julbouln/musicboxV2/README

New "La boîte à musique" firmware https://hackaday.io/project/6391-la-bote-musique

Using libopencm3 http://libopencm3.org/wiki/Main_Page drivers and atomthreads RTOS http://atomthreads.com/
