julbouln/musicboxV2/hardware/musicbox.brd

## EAGLE design hardware/musicbox.brd (2016-02-20)

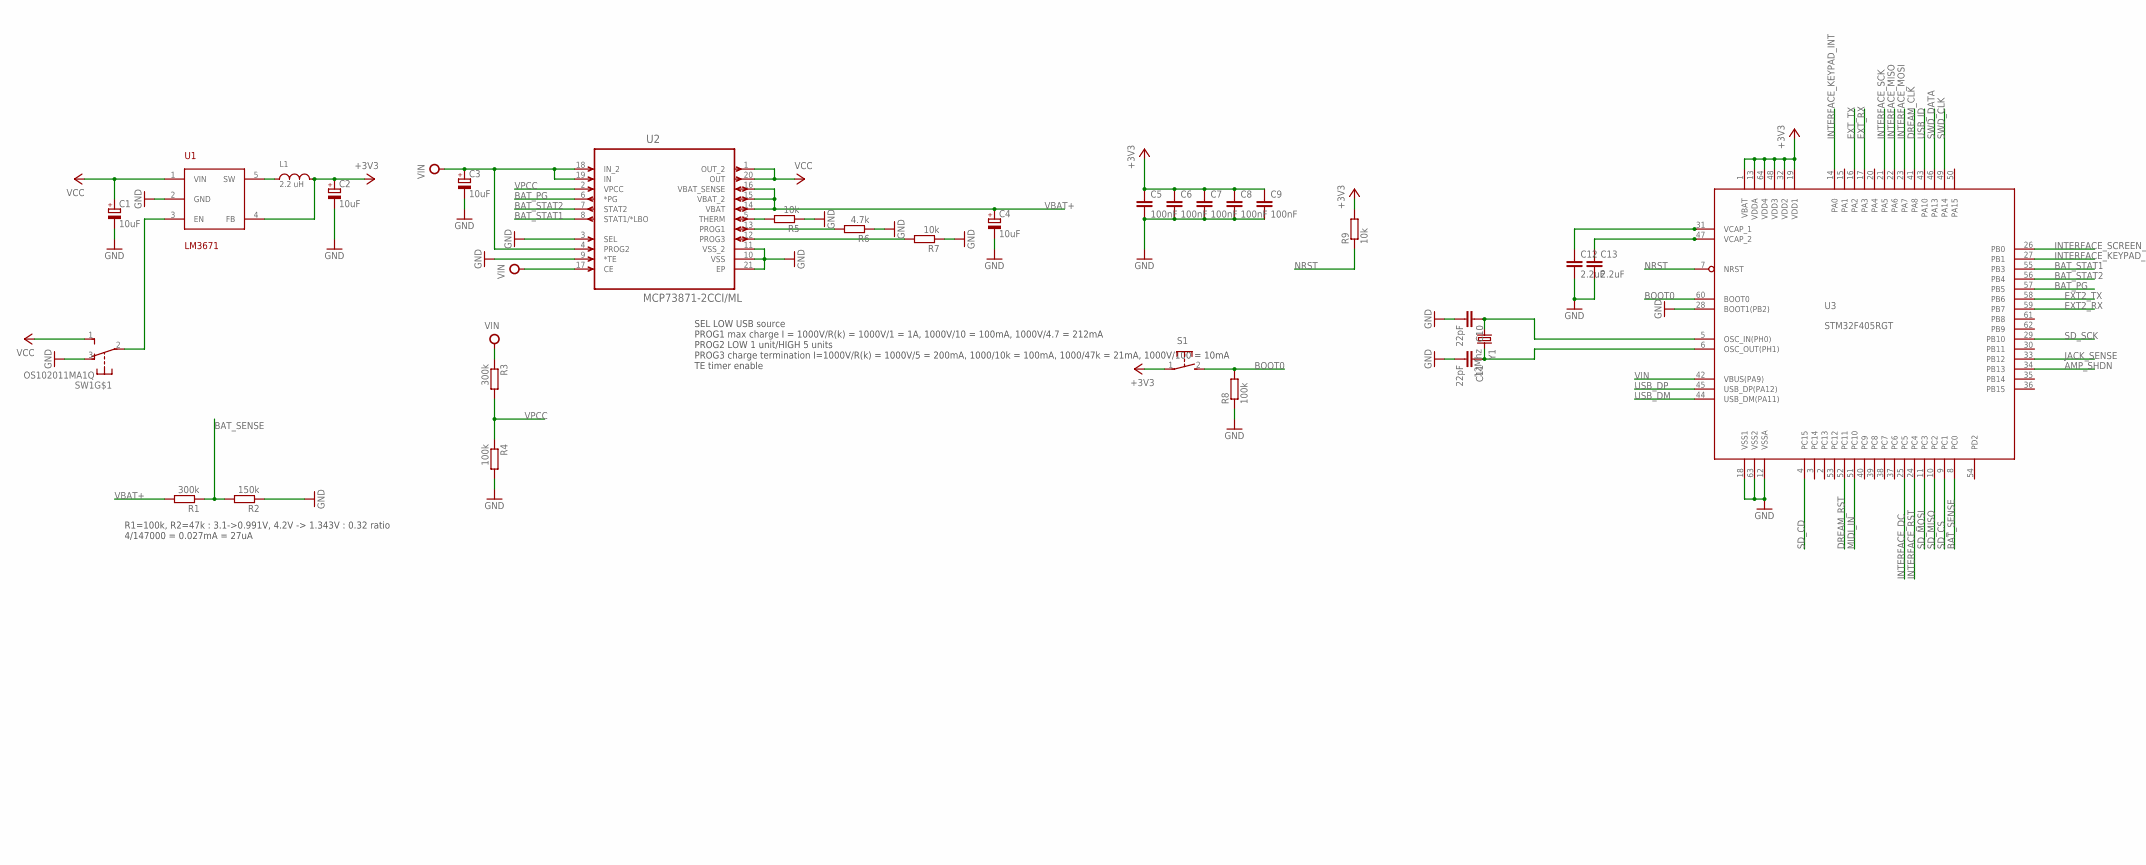
[picture p1: schematic musicbox.sch, part in row 1, column 1]

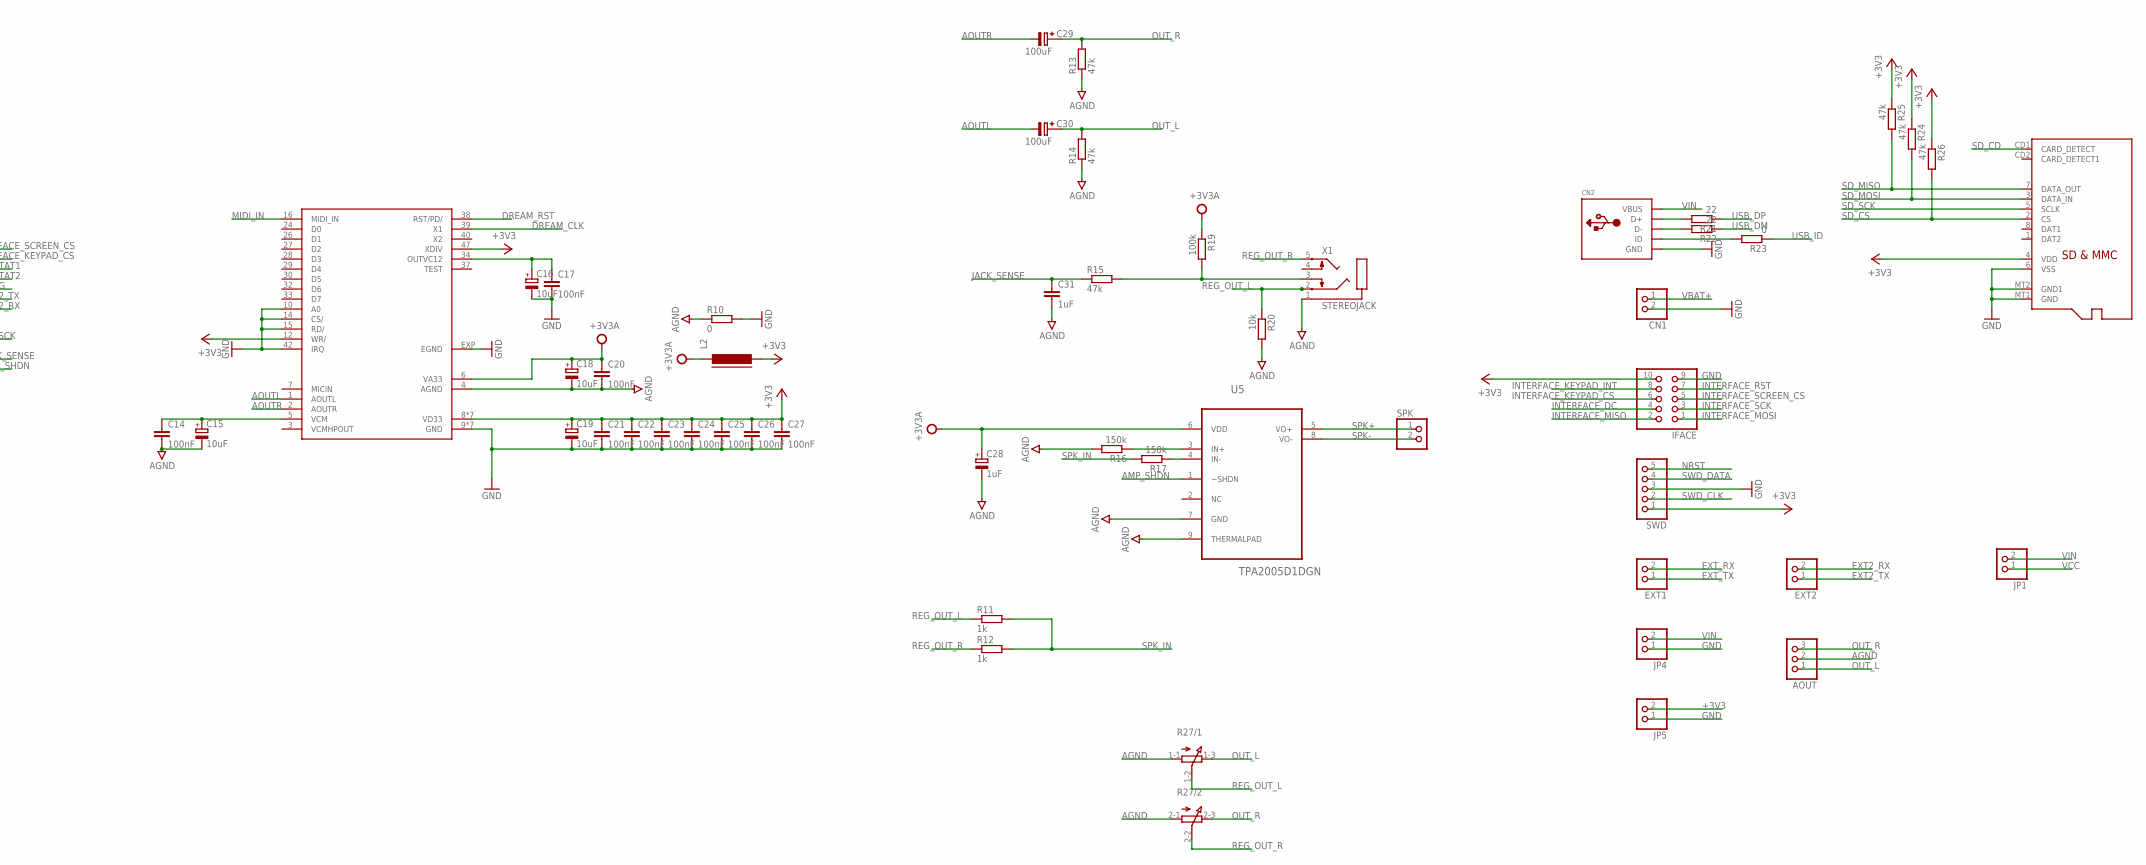
[picture p2: schematic musicbox.sch, part in row 1, column 2]

Parts:
AOUT: HEADER-1X3ROUND; 1X03_ROUND
C1, C2, C3, C4, C15, C16, C18, C19: 10uF; A/3216-18R
C5, C6, C7, C8, C9, C14, C17, C20, C21, C22, C23, C24, C25, C26, C27: 100nF; C0603K
C10, C11: 22pF; C0603K
C12, C13: 2.2uF; C0603K
C28: 1uF; A/3216-18R
C29, C30: 100uF; SV-B
C31: 1uF; C0603K
CN1: JST_2PIN-THM; JST-PH-2-THM
CN2: USBMOLEX; USB-MINIB-THM-MOLEX
EXT1, EXT2: HEADER-1X2ROUND; 1X02_ROUND
IFACE: HEADER-2X5; 2X05
JP1, JP4, JP5: HEADER-1X2ROUND; 1X02_ROUND
L1: 2.2 uH; 4X4MM
L2: FERRITE-0603; FB603
R1, R3: 300k; R0603
R2, R16, R17: 150k; R0603
R4, R8, R19: 100k; R0603
R5, R7, R9, R20: 10k; R0603
R6: 4.7k; R0603
R10, R23: 0; R0603
R11, R12: 1k; R0603
R13, R14, R15, R24, R25, R26: 47k; R0603
R21, R22: 22; R0603
R27: 3RP/1610G
S1: 31-XX; B3F-31XX
SPK: HEADER-1X2ROUND; 1X02_ROUND
SW1: OS102011MA1Q
SWD: HEADER-1X5ROUND; 1X05_ROUND
U1: LM3671; SOT23-5
U2: MCP73871-2CCI/ML; QFN50P400X400X100-21N
U3: STM32F405RGT; LQFP64
U4: SAM2695; QFN48
U5: TPA2005D1DGN; SOP65P488X107-9N
U6: MICROSD
X1: STEREOJACK; STX3100
Y1: 12Mhz; CRYSTAL-TXC-7A

Connections:
+3V3: C2.+, C5.1, C6.1, C7.1, C8.1, C9.1, C19.+, C21.1, C22.1, C23.1, C24.1, C25.1, C26.1, C27.1, IFACE.10, JP5.2, L1.2, L2.2, R9.2, R24.1, R25.1, R26.1, S1.1, SWD.1, U1.4 (FB), U3.1 (VBAT), U3.13 (VDDA), U3.19 (VDD1), U3.32 (VDD2), U3.48 (VDD3), U3.64 (VDD4), U4.8 (VD33), U4.11 (VD33), U4.12 (WR/), U4.20 (VD33), U4.31 (VD33), U4.35 (VD33), U4.41 (VD33), U4.46 (VD33), U4.47 (XDIV), U6.4 (VDD)
+3V3A: C18.+, C20.1, C28.+, L2.1, R19.1, U4.6 (VA33), U5.6 (VDD)
AGND: AOUT.2, C14.2, C15.-, C18.-, C20.2, C28.-, C31.2, R10.1, R13.1, R14.1, R16.2, R20.2, R27.1-1 (A), R27.2-1 (A), U4.4 (AGND), U5.7 (GND), U5.9 (THERMALPAD), X1.1
AMP_SHDN: U3.34 (PB13), U5.1 (~SHDN)
AOUTL: C30.-, U4.1 (AOUTL)
AOUTR: C29.-, U4.2 (AOUTR)
BAT_PG: U2.6 (*PG), U3.57 (PB5)
BAT_SENSE: R1.1, R2.2, U3.8 (PC0)
BAT_STAT1: U2.8 (STAT1/*LBO), U3.55 (PB3)
BAT_STAT2: U2.7 (STAT2), U3.56 (PB4)
BOOT0: R8.2, S1.2 (S), U3.60 (BOOT0)
DREAM_CLK: U3.41 (PA8), U4.39 (X1)
DREAM_RST: U3.52 (PC11), U4.38 (RST/PD/)
EXT2_RX: EXT2.2, U3.59 (PB7)
EXT2_TX: EXT2.1, U3.58 (PB6)
EXT_RX: EXT1.2, U3.17 (PA3)
EXT_TX: EXT1.1, U3.16 (PA2)
GND: C1.-, C2.-, C3.-, C4.-, C5.2, C6.2, C7.2, C8.2, C9.2, C10.2, C11.2, C12.2, C13.2, C16.-, C17.2, C19.-, C21.2, C22.2, C23.2, C24.2, C25.2, C26.2, C27.2, CN1.2 (1), CN2.GND, IFACE.9, JP4.1, JP5.1, R2.1, R4.2, R5.1, R6.1, R7.1, R8.1, R10.2, SW1.3 (O), SWD.3, U1.2 (GND), U2.3 (SEL), U2.9 (*TE), U2.10 (VSS), U2.11 (VSS_2), U2.21 (EP), U3.12 (VSSA), U3.18 (VSS1), U3.28 (BOOT1(PB2)), U3.63 (VSS2), U4.9 (GND), U4.10 (A0), U4.13 (GND), U4.14 (CS/), U4.15 (RD/), U4.18 (GND), U4.25 (GND), U4.36 (GND), U4.42 (IRQ), U4.45 (GND), U4.48 (GND), U4.EXP (EGND), U6.6 (VSS), U6.MT1 (GND), U6.MT2 (GND1)
INTERFACE_DC: IFACE.4, U3.25 (PC5)
INTERFACE_KEYPAD_CS: IFACE.6, U3.27 (PB1)
INTERFACE_KEYPAD_INT: IFACE.8, U3.14 (PA0)
INTERFACE_MISO: IFACE.2, U3.22 (PA6)
INTERFACE_MOSI: IFACE.1, U3.23 (PA7)
INTERFACE_RST: IFACE.7, U3.24 (PC4)
INTERFACE_SCK: IFACE.3, U3.21 (PA5)
INTERFACE_SCREEN_CS: IFACE.5, U3.26 (PB0)
JACK_SENSE: C31.1, R15.1, U3.33 (PB12)
MIDI_IN: U3.51 (PC10), U4.16 (MIDI_IN)
unnamed: C12.1, U3.31 (VCAP_1)
unnamed: C11.1, U3.6 (OSC_OUT(PH1)), Y1.P$2 (2)
unnamed: C10.1, U3.5 (OSC_IN(PH0)), Y1.P$1 (1)
unnamed: C16.+, C17.1, U4.34 (OUTVC12)
unnamed: C14.1, C15.+, U4.5 (VCM)
unnamed: CN2.D+, R21.2
unnamed: C13.1, U3.47 (VCAP_2)
unnamed: L1.1, U1.5 (SW)
unnamed: CN2.D-, R22.2
unnamed: SW1.2, U1.3 (EN)
unnamed: CN2.ID, R23.2
unnamed: R5.2, U2.5 (THERM)
unnamed: R7.2, U2.12 (PROG3)
unnamed: R6.2, U2.13 (PROG1)
unnamed: R17.1, U5.4 (IN-)
unnamed: R16.1, U5.3 (IN+)
unnamed: R15.2, R19.2, X1.3
NRST: R9.1, SWD.5, U3.7 (NRST)
OUT_L: AOUT.1, C30.+, R14.2, R27.1-3 (E)
OUT_R: AOUT.3, C29.+, R13.2, R27.2-3 (E)
REG_OUT_L: R11.1, R20.1, R27.1-2 (S), X1.2
REG_OUT_R: R12.1, R27.2-2 (S), X1.5
SD_CD: U3.4 (PC15), U6.CD1 (CARD_DETECT)
SD_CS: R26.2, U3.9 (PC1), U6.2 (CS)
SD_MISO: R25.2, U3.10 (PC2), U6.7 (DATA_OUT)
SD_MOSI: R24.2, U3.11 (PC3), U6.3 (DATA_IN)
SD_SCK: U3.29 (PB10), U6.5 (SCLK)
SPK+: SPK.1, U5.5 (VO+)
SPK-: SPK.2, U5.8 (VO-)
SPK_IN: R11.2, R12.2, R17.2
SWD_CLK: SWD.2, U3.49 (PA14)
SWD_DATA: SWD.4, U3.46 (PA13)
USB_DM: R22.1, U3.44 (USB_DM(PA11))
USB_DP: R21.1, U3.45 (USB_DP(PA12))
USB_ID: R23.1, U3.43 (PA10)
VBAT+: C4.+, CN1.1 (2), R1.2, U2.14 (VBAT), U2.15 (VBAT_2), U2.16 (VBAT_SENSE)
VCC: C1.+, JP1.1, SW1.1 (S), U1.1 (VIN), U2.1 (OUT_2), U2.20 (OUT)
VIN: C3.+, CN2.VBUS, JP1.2, JP4.2, R3.1, U2.4 (PROG2), U2.17 (CE), U2.18 (IN_2), U2.19 (IN), U3.42 (VBUS(PA9))
VPCC: R3.2, R4.1, U2.2 (VPCC)

Notes on the sheet:
SEL LOW USB source PROG1 max charge I = 1000V/R(k) = 1000V/1 = 1A, 1000V/10 = 100mA, 1000V/4.7 = 212mA PROG2 LOW 1 unit/HIGH 5 units PROG3 charge termination I=1000V/R(k) = 1000V/5 = 200mA, 1000/10k = 100mA, 1000/47k = 21mA, 1000V/100 = 10mA TE timer enable
R1=100k, R2=47k : 3.1->0.991V, 4.2V -> 1.343V : 0.32 ratio 4/147000 = 0.027mA = 27uA

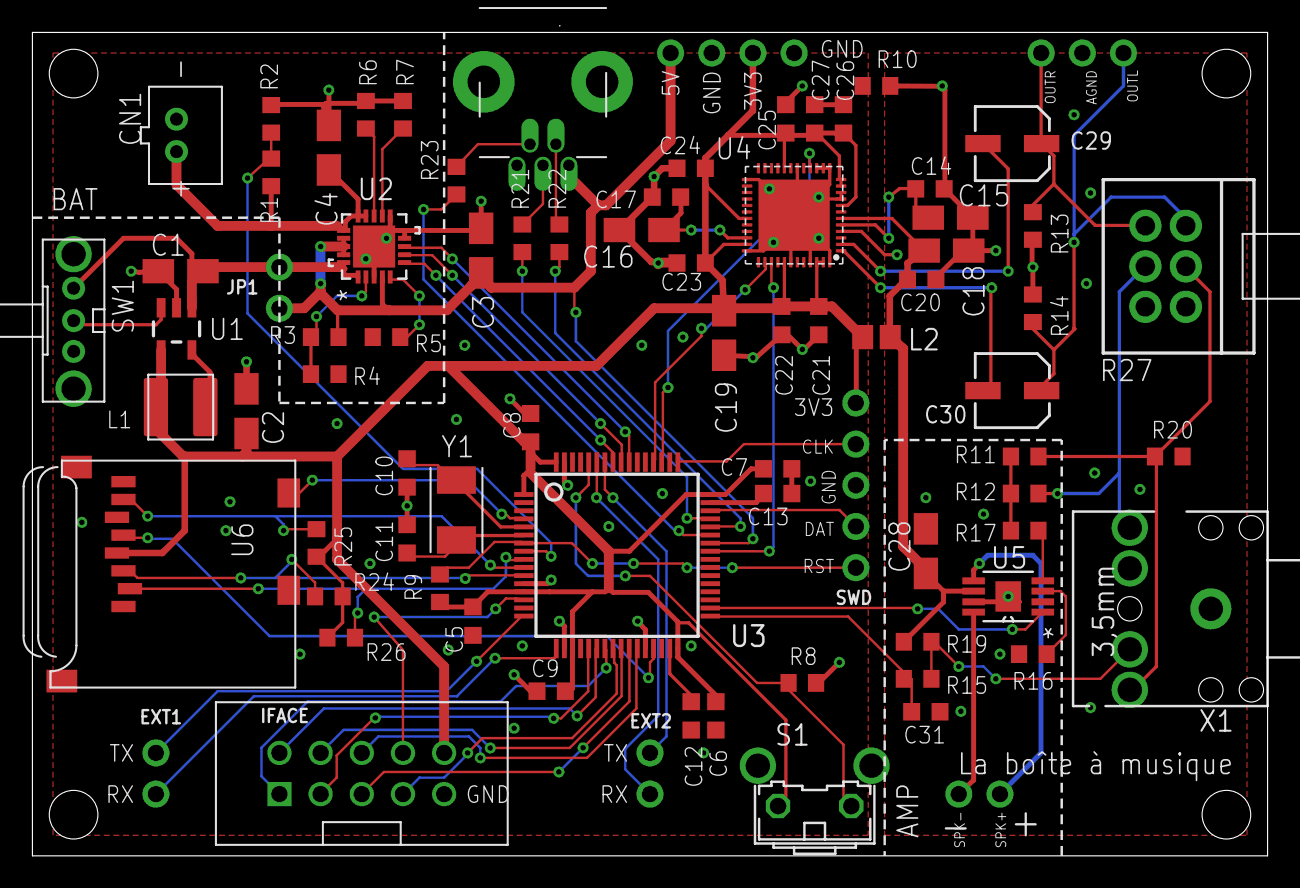
[picture p3: board musicbox.brd from above]

Board: 2 copper layers, 76.2 x 50.8 mm, 81 parts (1 on the bottom side), 67 nets.

Other parts of the board:
U$1: PANDA
